nuclearcat/ESP32ETH/MULTIGW.pdf

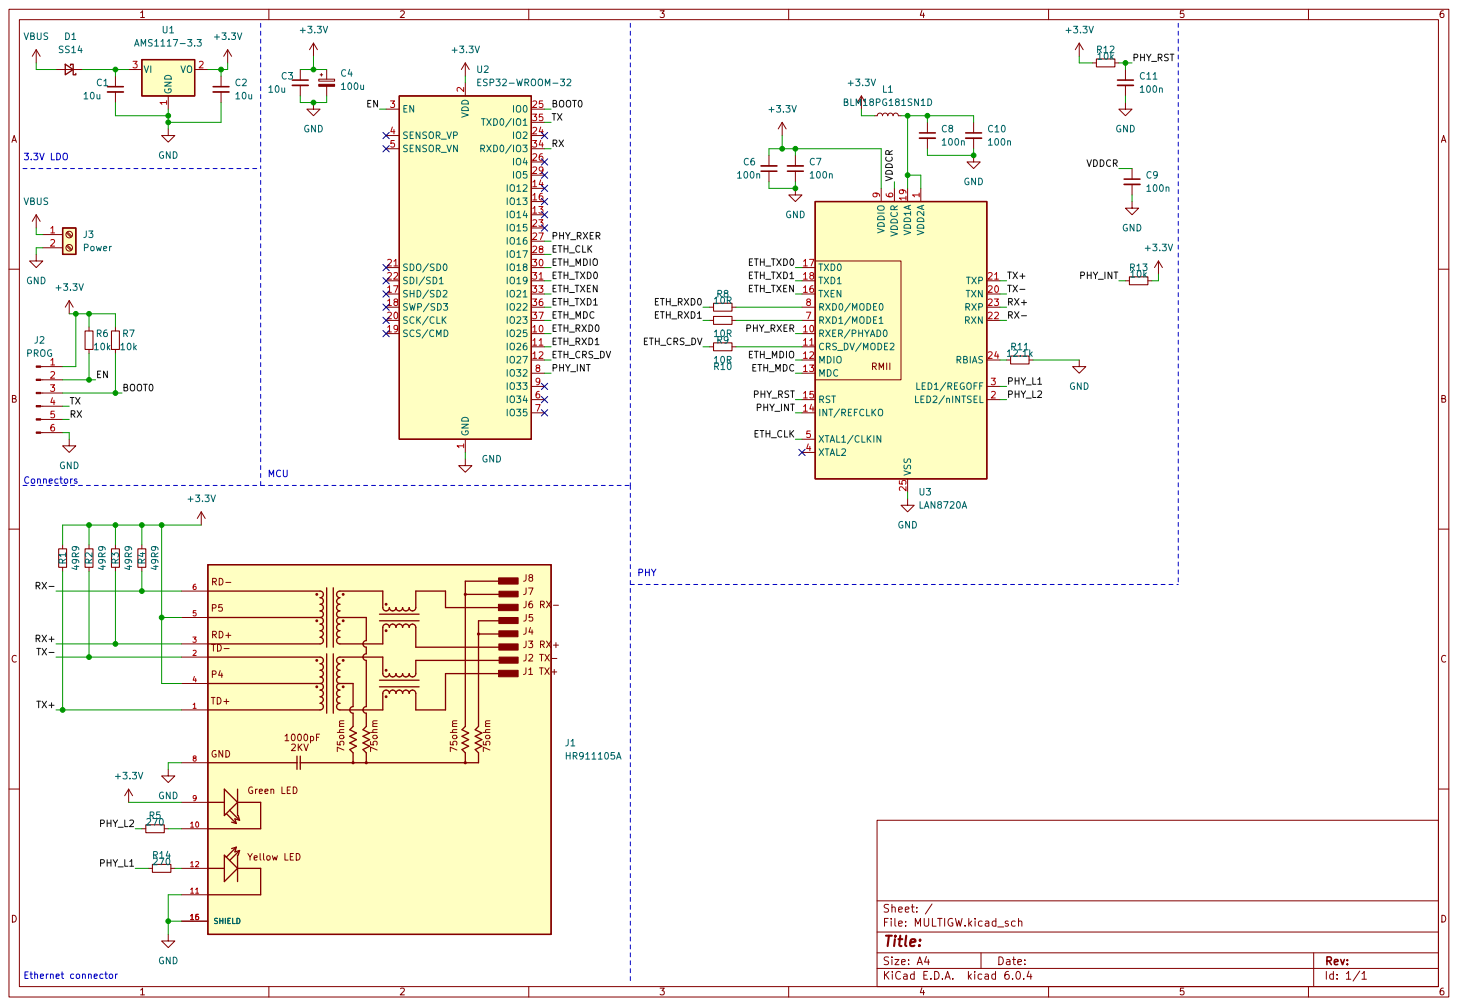
[picture p1: page 1]
