nuclearcat/ESP32ETH/MULTIGW.kicad_pcb

## KiCad design MULTIGW.kicad_pcb (2022-07-08)

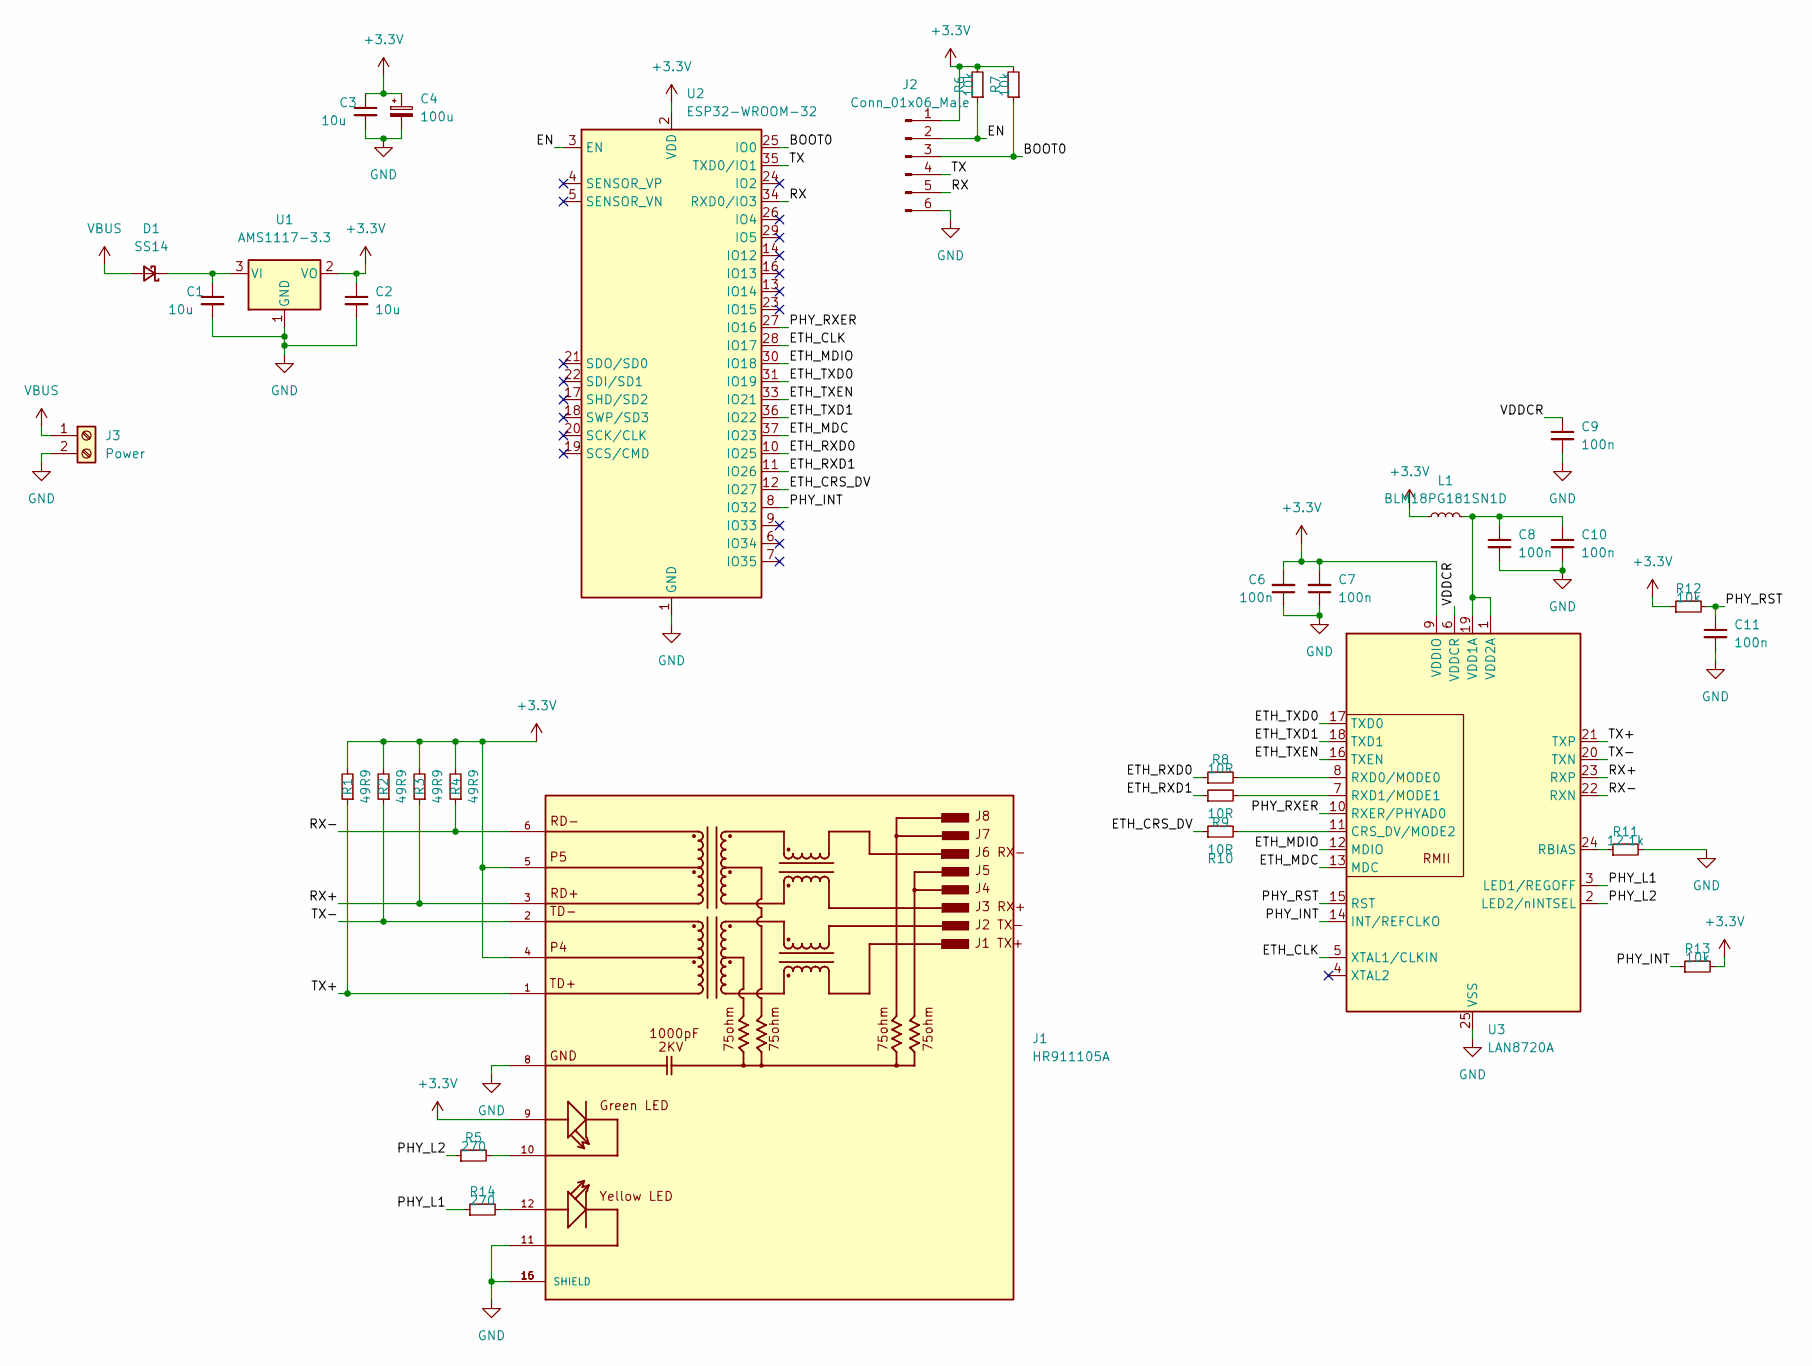
[picture p2: schematic MULTIGW.kicad_sch]

Parts:
C1: 10u; R_0603_1608Metric
C2, C3: 10u; C_0603_1608Metric
C4: 100u; CP_EIA-3528-21_Kemet-B
C6, C7, C8, C9, C10, C11: 100n; C_0603_1608Metric
D1: SS14; D_SMA
J1: HR911105A; HANRUN_HR911105A; PARTREV A
J2: Conn_01x06_Male; PinHeader_1x06_P2.54mm_Vertical
J3: Power; TerminalBlock_4Ucon_1x02_P3.50mm_Vertical
L1: BLM18PG181SN1D; R_0603_1608Metric
R1, R2, R3, R4: 49R9; R_0603_1608Metric
R5, R14: 270; R_0603_1608Metric
R6, R7, R12, R13: 10k; R_0603_1608Metric
R8, R9, R10: 10R; R_0603_1608Metric
R11: 12.1k; R_0603_1608Metric
U1: AMS1117-3.3; SOT-223-3_TabPin2
U2: ESP32-WROOM-32
U3: LAN8720A; QFN-24-1EP_4x4mm_P0.5mm_EP2.6x2.6mm

Connections:
+3V3: C2.1, C3.1, C4.1, C6.2, C7.2, J1.4, J1.5, J1.9, J2.1, L1.1, R1.2, R2.2, R3.2, R4.2, R6.2, R7.2, R12.1, R13.2, U1.2 (VO), U2.2 (VDD), U3.9 (VDDIO)
/BOOT0: J2.3, R7.1, U2.25 (IO0)
/EN: J2.2, R6.1, U2.3 (EN)
/ETH_CLK: U2.28 (IO17), U3.5 (XTAL1/CLKIN)
/ETH_CRS_DV: R10.1, U2.12 (IO27)
/ETH_MDC: U2.37 (IO23), U3.13 (MDC)
/ETH_MDIO: U2.30 (IO18), U3.12 (MDIO)
/ETH_RXD0: R8.1, U2.10 (IO25)
/ETH_RXD1: R9.1, U2.11 (IO26)
/ETH_TXD0: U2.31 (IO19), U3.17 (TXD0)
/ETH_TXD1: U2.36 (IO22), U3.18 (TXD1)
/ETH_TXEN: U2.33 (IO21), U3.16 (TXEN)
/PHY_INT: R13.1, U2.8 (IO32), U3.14 (INT/REFCLKO)
/PHY_L1: R14.1, U3.3 (LED1/REGOFF)
/PHY_L2: R5.1, U3.2 (LED2/nINTSEL)
/PHY_RST: C11.1, R12.2, U3.15 (RST)
/PHY_RXER: U2.27 (IO16), U3.10 (RXER/PHYAD0)
/RX: J2.5, U2.34 (RXD0/IO3)
/RX+: J1.3, R3.1, U3.23 (RXP)
/RX-: J1.6, R4.1, U3.22 (RXN)
/TX: J2.4, U2.35 (TXD0/IO1)
/TX+: J1.1, R1.1, U3.21 (TXP)
/TX-: J1.2, R2.1, U3.20 (TXN)
/VDDCR: C9.1, U3.6 (VDDCR)
GND: C1.2, C2.2, C3.2, C4.2, C6.1, C7.1, C8.2, C9.2, C10.2, C11.2, J1.8, J1.11, J1.15 (SHIELD), J1.16 (SHIELD), J2.6, J3.2, R11.2, U1.1 (GND), U2.1 (GND), U2.15 (GND), U2.38 (GND), U2.39 (GND), U3.25 (VSS)
unnamed: C1.1, D1.1 (K), U1.3 (VI)
unnamed: C8.1, C10.1, L1.2, U3.1 (VDD2A), U3.19 (VDD1A)
unnamed: J1.10, R5.2
unnamed: J1.12, R14.2
unnamed: R8.2, U3.8 (RXD0/MODE0)
unnamed: R9.2, U3.7 (RXD1/MODE1)
unnamed: R10.2, U3.11 (CRS_DV/MODE2)
unnamed: R11.1, U3.24 (RBIAS)
VBUS: D1.2 (A), J3.1

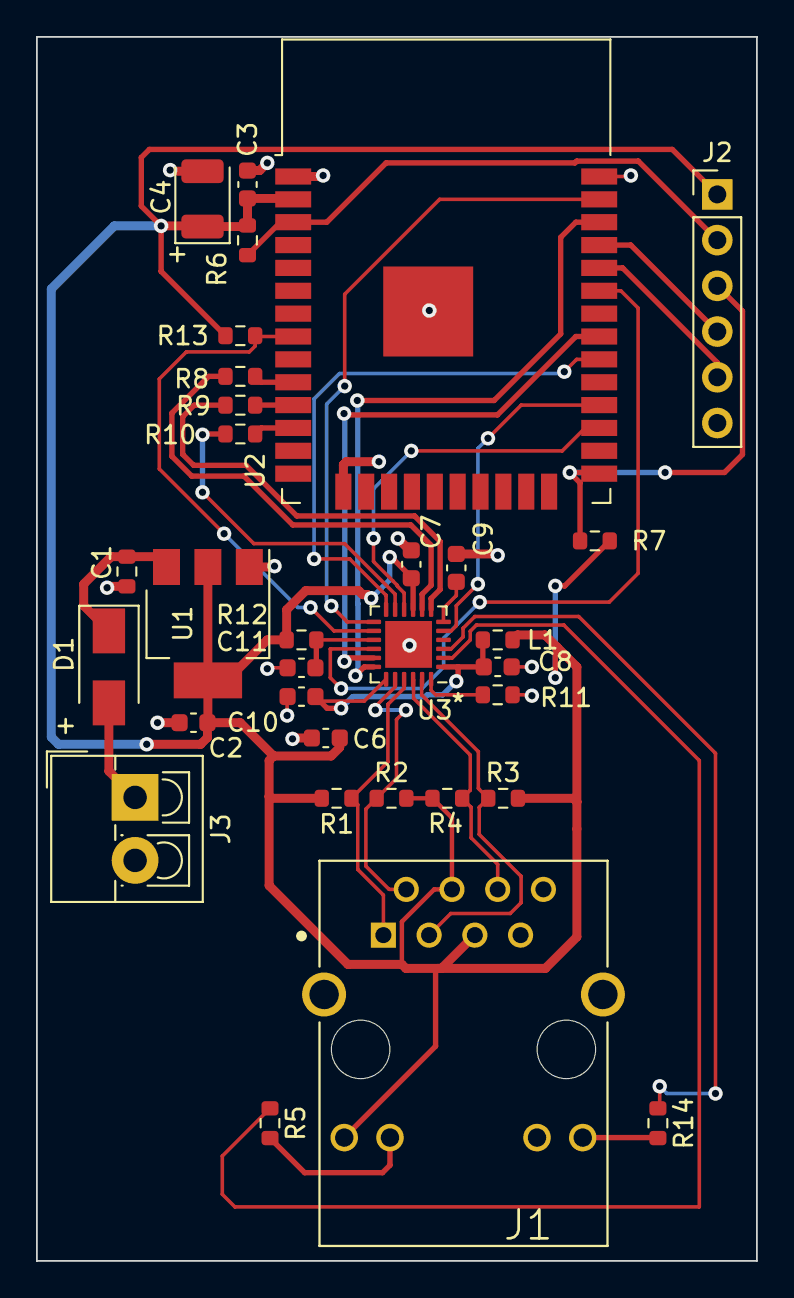
[picture p3: board MULTIGW.kicad_pcb from above]

Board: 2 copper layers, 40.0 x 68.0 mm, 32 parts (0 on the bottom side), 34 nets.
