nuclearcat/ESP32ETH/(commit log)

2022-07-08 Verified design
    [MULTIGW.kicad_pcb, MULTIGW.kicad_sch]
2022-07-08 Small tidy up
    [MULTIGW.kicad_sch]
2022-07-08 Add JLCPCB gerbers and PCBA files
    [MULTIGW-CuBottom.gbr, MULTIGW-CuTop.gbr, MULTIGW-EdgeCuts.gbr, MULTIGW-MaskBottom.gbr, MULTIGW-MaskTop.gbr, MULTIGW-NPTH.drl, MULTIGW-PTH.drl, MULTIGW-PasteBottom.gbr]
